jburch602/STM32F446RE_MPU6050_IMU/docs/images/v2_closed_loop_demo_thumbnail.jpg

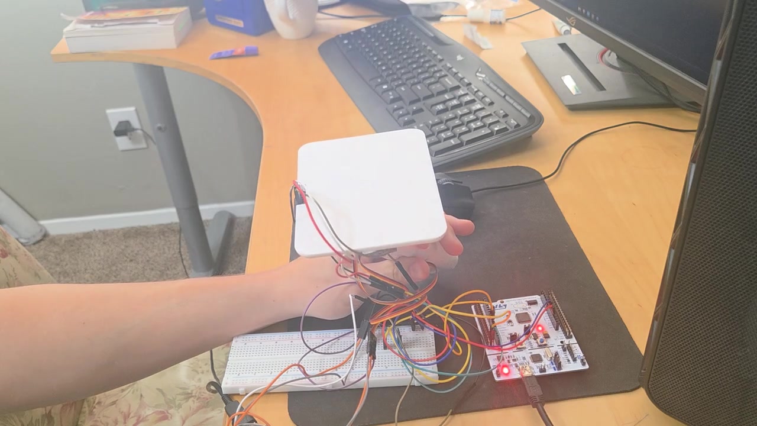
docs/images/v2_closed_loop_demo_thumbnail.jpg
