jburch602/STM32F446RE_MPU6050_IMU/docs/validation/spreadsheets/closed_loop_stabilization_2026-09-14.xlsx

Sheet: Overview
Closed-Loop Stabilization Validation
STM32F446RE + MPU6050 + two MG90S servos | September 14, 2026
Configuration | Value | Capture summary | Result
Control loop | 100 Hz | Samples | 800
Telemetry | 20 Hz | Analyzed window | 40.0 s
Controller | PI + direct gyro-rate damping | Max |relative pitch| | 15.87 deg
Kp (pitch / roll) | 1.25 / 1.25 | Max |relative roll| | 12.21 deg
Ki (pitch / roll) | 1.00 / 1.00 | Max |pitch command| | 60.00 deg
Krate (pitch / roll) | 0.05 / 0.05 | Max |roll command| | 56.54 deg
Attitude deadband | 0.5 deg | Mean dt | 0.0100 s
Servo command limit | +/-60 deg
Test notes
The workbook preserves the 90-130 s portion of the paired video/telemetry run, including baseline before motion and settling afterward. The source recording continued for several minutes after visible movement ended; that stationary tail is intentionally excluded. The source text contained one incomplete final CSV row, which was also excluded.
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
