jburch602/STM32F446RE_MPU6050_IMU/docs/validation/spreadsheets/servo_hysteresis_characterization_v1_v2.xlsx

Sheet: Raw_V1
V1 Raw Telemetry — Curated Near-Center Test
Copied verbatim from the prior curated V1 hysteresis workbook.
Time_ms | dt | AX_g | AY_g | AZ_g | GX_dps | GY_dps | GZ_dps | Pitch | Roll | Yaw | PitchError_deg | RollError_deg | PitchCommand_deg | RollCommand_deg | State | DataValid | SampleCount | ValidCount | FailedRead | FailedDt | FailedAngle | FailedTelemetry | ReadErrPct | TotalErrPct
13070 | 0.01 | 0.002 | -0.001 | 0.999 | 0.664 | -0.427 | 0.458 | -0.01 | -0.013 | 0.011 | 0 | 0 | 0 | 0 | 2 | 1 | 5 | 5 | 0 | 0 | 0 | 0 | 0 | 0
13120 | 0.01 | -0.005 | -0.001 | 0.985 | -0.198 | 0.321 | -0.183 | -0.009 | -0.018 | 0.008 | 0 | 0 | 0 | 0 | 2 | 1 | 10 | 10 | 0 | 0 | 0 | 0 | 0 | 0
13170 | 0.01 | 0.004 | 0.01 | 1.022 | -0.145 | -0.031 | 0.198 | 0.017 | 0.028 | 0.018 | 0 | 0 | 0 | 0 | 2 | 1 | 15 | 15 | 0 | 0 | 0 | 0 | 0 | 0
13220 | 0.01 | -0.015 | -0.011 | 0.993 | 0.679 | -0.282 | 0.42 | -0.001 | 0.004 | 0.012 | 0 | 0 | 0 | 0 | 2 | 1 | 20 | 20 | 0 | 0 | 0 | 0 | 0 | 0
13270 | 0.01 | -0.006 | 0.003 | 0.984 | -0.313 | -0.206 | -0.397 | -0.02 | 0.009 | 0.012 | 0 | 0 | 0 | 0 | 2 | 1 | 25 | 25 | 0 | 0 | 0 | 0 | 0 | 0
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
