jburch602/STM32F446RE_MPU6050_IMU/docs/validation/spreadsheets/deadband_baseline_db0.xlsx

Sheet: Raw Log
Time_ms | dt | AX_g | AY_g | AZ_g | GX_dps | GY_dps | GZ_dps | Pitch | Roll | Yaw | PitchError_deg | RollError_deg | PitchCommand_deg | RollCommand_deg | State | DataValid | SampleCount | ValidCount | FailedRead | FailedDt | FailedAngle | FailedTelemetry | ReadErrPct | TotalErrPct | Elapsed_s
13047 | 0.0000 | -0.006 | -0.008 | 0.999 | -0.137 | 0.153 | -0.061 | -0.007 | -0.009 | 0.000 | 0.007 | 0.009 | -0.007 | -0.009 | 2 | 1 | 1 | 1 | 0 | 0 | 0 | 0 | 0.000 | 0.000 | 0.000
13071 | 0.0240 | -0.003 | -0.001 | 1.006 | -0.160 | 0.130 | 0.023 | -0.007 | -0.007 | 0.001 | 0.007 | 0.007 | -0.007 | -0.007 | 2 | 1 | 2 | 2 | 0 | 0 | 0 | 0 | 0.000 | 0.000 | 0.024
13095 | 0.0240 | -0.011 | -0.003 | 1.004 | 0.115 | 0.137 | -0.183 | -0.017 | -0.013 | -0.004 | 0.017 | 0.013 | -0.017 | -0.013 | 2 | 1 | 3 | 3 | 0 | 0 | 0 | 0 | 0.000 | 0.000 | 0.048
13119 | 0.0240 | -0.005 | -0.003 | 1.019 | -0.031 | -0.260 | -0.382 | -0.028 | -0.014 | -0.013 | 0.028 | 0.014 | -0.028 | -0.014 | 2 | 1 | 4 | 4 | 0 | 0 | 0 | 0 | 0.000 | 0.000 | 0.072
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
