jburch602/STM32F446RE_MPU6050_IMU/docs/validation/spreadsheets/servo_hysteresis_near_center.xlsx

Sheet: Summary
Near-Center Servo Hysteresis / Dead-Zone Analysis
Test method

Sheet: Raw Telemetry
Time_ms | dt | AX_g | AY_g | AZ_g | GX_dps | GY_dps | GZ_dps | Pitch | Roll | Yaw | PitchError_deg | RollError_deg | PitchCommand_deg | RollCommand_deg | State | DataValid | SampleCount | ValidCount | FailedRead | FailedDt | FailedAngle | FailedTelemetry | ReadErrPct | TotalErrPct
13070.0000 | 0.0100 | 0.002 | -0.001 | 0.999 | 0.664 | -0.427 | 0.458 | -0.010 | -0.013 | 0.011 | 0.000 | 0.000 | 0.000 | 0.000 | 2.000 | 1.000 | 5.000 | 5.000 | 0.000 | 0.000 | 0.000 | 0.000 | 0.000 | 0.000
13120.0000 | 0.0100 | -0.005 | -0.001 | 0.985 | -0.198 | 0.321 | -0.183 | -0.009 | -0.018 | 0.008 | 0.000 | 0.000 | 0.000 | 0.000 | 2.000 | 1.000 | 10.000 | 10.000 | 0.000 | 0.000 | 0.000 | 0.000 | 0.000 | 0.000
13170.0000 | 0.0100 | 0.004 | 0.010 | 1.022 | -0.145 | -0.031 | 0.198 | 0.017 | 0.028 | 0.018 | 0.000 | 0.000 | 0.000 | 0.000 | 2.000 | 1.000 | 15.000 | 15.000 | 0.000 | 0.000 | 0.000 | 0.000 | 0.000 | 0.000
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
