jburch602/STM32F446RE_MPU6050_IMU/docs/validation/spreadsheets/slew_rate_aggressive_reversal_120dps.xlsx

Sheet: Raw Log
Time_ms | dt | AX_g | AY_g | AZ_g | GX_dps | GY_dps | GZ_dps | Pitch | Roll | Yaw | PitchError_deg | RollError_deg | PitchCommand_deg | RollCommand_deg | State | DataValid | SampleCount | ValidCount | FailedRead | FailedDt | FailedAngle | FailedTelemetry | ReadErrPct | TotalErrPct | Elapsed_s
13047 | 0.0000 | 0.010 | 0.002 | 1.006 | -0.092 | -0.122 | 0.313 | 0.011 | 0.002 | 0.000 | 0.000 | 0.000 | 0.000 | 0.000 | 2 | 1 | 1 | 1 | 0 | 0 | 0 | 0 | 0.000 | 0.000 | 0.000
13071 | 0.0240 | -0.011 | -0.004 | 0.998 | 0.031 | 0.145 | -0.168 | 0.002 | -0.003 | -0.004 | 0.000 | 0.000 | 0.000 | 0.000 | 2 | 1 | 2 | 2 | 0 | 0 | 0 | 0 | 0.000 | 0.000 | 0.024
13095 | 0.0240 | 0.005 | 0.004 | 1.003 | -0.053 | -0.099 | -0.015 | 0.005 | 0.003 | -0.004 | 0.000 | 0.000 | 0.000 | 0.000 | 2 | 1 | 3 | 3 | 0 | 0 | 0 | 0 | 0.000 | 0.000 | 0.048
13119 | 0.0240 | 0.012 | 0.004 | 0.997 | -0.160 | 0.153 | -0.053 | 0.022 | 0.011 | -0.006 | 0.000 | 0.000 | 0.000 | 0.000 | 2 | 1 | 4 | 4 | 0 | 0 | 0 | 0 | 0.000 | 0.000 | 0.072
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
