jburch602/STM32F446RE_MPU6050_IMU/docs/validation/images/near_center_hysteresis.png

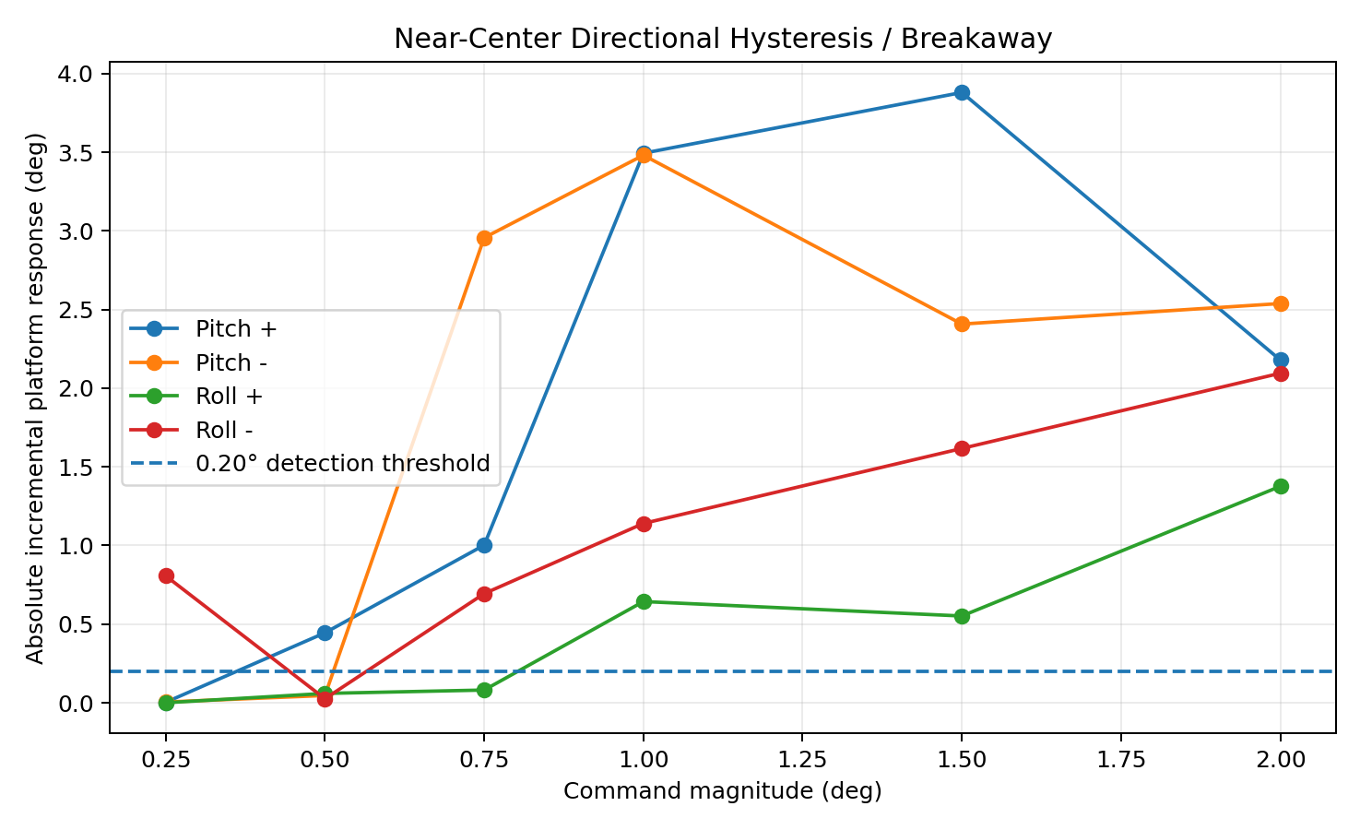
docs/validation/images/near_center_hysteresis.png
