jburch602/STM32F446RE_MPU6050_IMU/Core/Inc/power_monitor.h

/*
 * power_monitor.h
 *
 * Created on: Jul 8, 2026
 * Author: Jackson
 */

#ifndef INC_POWER_MONITOR_H_
#define INC_POWER_MONITOR_H_

#include "stm32f4xx_hal.h"


// Power system state
typedef enum {
    POWER_OK = 0,
    POWER_WARNING = 1,
    POWER_FAULT = 2
} Power_State_t;


// Power monitoring data
typedef struct {
    float voltage_raw;
    float voltage_filtered;
    float voltage_min;
    float voltage_max;

    Power_State_t state;

    uint32_t warning_count;
    uint32_t fault_count;
} Power_Monitor_t;


// Initializes power monitoring structure
HAL_StatusTypeDef Power_Manager_Init(
    Power_Monitor_t *monitor
);


// Reads voltage data from ADC
HAL_StatusTypeDef Power_Manager_Read(
    ADC_HandleTypeDef *hadc,
    Power_Monitor_t *monitor
);


// Updates power state based on voltage data
HAL_StatusTypeDef Power_Manager_Update(
    Power_Monitor_t *monitor
);


#endif /* INC_POWER_MONITOR_H_ */
