jburch602/STM32F446RE_MPU6050_IMU/(commit log)

2026-07-01 Initial STM32F446RE MPU6050 IMU project
2026-07-02 Add WHO_AM_I check and sensor data struct
2026-07-02 Add function to read accelerometer data
    Has NULL pointer validation
2026-07-02 Added function for gyro raw read
    Also added test code in main.c
2026-07-02 Added UART2 serial output
2026-07-03 Added time to print, logged csv
    From about 40min data
    gyro avg bias
    gyro_x = -1.89 DPS
    gyro_y = -1.20 DPS
    gyro_z = -3.65 DPS
    accelerometer avg bias
    accel_x = 0.019 g
    accel_y = 0.012 g
    accel_z = 1.102 g
2026-07-04 Add sample calibration
    Mean values after calibration
    accel_x_g: -0.00068 g
    accel_y_g: -0.00107 g
    accel_z_g: 0.99885 g
    gyro_x_dps: 0.03786 dps
    gyro_y_dps: 0.00861 dps
    gyro_z_dps: -0.03247 dps
    this represents about 98.8% improvement from pre-calibrated data
    gyro drift is about 1.95deg/min instead of 219deg/min
    [main.c, mpu6050.c, mpu6050.h]
2026-07-04 Add angles and complementary filter
    Implement pitch, roll, and yaw angle estimation using a complementary filter that combines accelerometer and gyroscope data.
    Adds MPU6050_Angles_t struct to store angle state and timing information.
    Introduces three new functions: MPU6050_Update_dt() for delta time calculation, MPU6050_Calculate_Angles() for angle computation, and MPU6050_Update_All() to orchestrate all operations.
    Updates main.c to output angles in CSV format alongside IMU sensor data.
    Needs explanatory comments
    Pitch and roll are about stationary
    Noise significantly reduced by complementary filter ~90%
    Yaw drifts 0.63 deg/min
    Yaw is hardware limited by the MPU6050 lack of a magnetomet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
    [main.c, mpu6050.c, mpu6050.h]
2026-07-04 Refactor timing and angle calculations
    add imu_filter.c for modularity
2026-07-04 Add system health monitoring module
    Introduce system health monitoring infrastructure with System_State_t enum tracking boot, calibration, running, and error states. Define System_Health_t structure to track sample counts, error metrics, HAL status codes, and health statistics.
    [system_health.c, system_health.h, telemetry.h]
2026-07-05 Implement system health monitor
    Add system health tracking module to monitor MPU6050 sensor performance and errors. Includes:
    - New System_Health_t struct with detailed error counters and statistics
    - Refined system state enum with separate DT and angle error states
    - Functions for recording samples, errors, and calculating error rates
    - Integration into main loop to track sensor reliability
    - Fixed include guard typo in telemetry.h and improved code formatting
    [main.c, system_health.c, system_health.h, telemetry.h]
2026-07-05 Integrate system health into telemetry
    Add system health monitoring to telemetry output and initialization flow. Includes health metrics in CSV data logging, sends status messages during MPU initialization and calibration, and adds new Telemetry_Send_Status() function for reporting system state changes over UART.
2026-07-05 Add I2C bus recovery on startup
    Implement an I2C bus recovery routine to handle stuck I2C1 bus issues that occur during rapid firmware restarts. The recovery logic manually pulses SCL up to 9 times to release a stuck SDA line, then generates a STOP condition. This routine is called before normal I2C1 initialization to prevent HAL_BUSY errors during MPU6050 initialization. Also added boot status telemetry message.
    [i2c_manager.c, i2c_manager.h, main.c]
2026-09-05 Add Power Monitor
    WIP code, likely to refactor
2026-09-05 Add Servo 1 test
    CubeMX generated
2026-09-07 Add servo control and IMU updates
    This change adds PWM servo support for pitch and roll channels, configures TIM4/TIM8 outputs, and initializes the servos during boot. It also updates the IMU complementary filter to use calibrated physical pitch/roll axes, integrates yaw, and improves timing handling. The main loop now initializes the MPU6050, calibrates it, streams telemetry, and monitors health while driving the servos. Power-monitor APIs were cleaned up and aligned with the HAL signatures.
2026-09-07 Add gimbal module and replace direct servo control
    Introduce a gimbal module (Core/Inc/gimbal.h and Core/Src/gimbal.c) that encapsulates pitch/roll Servo_t instances, calibration constants (min/center/max pulses), servo direction signs, KP gains, and a clamp for safe motion. Implements Gimbal_Init, Gimbal_Center and Gimbal_Update to initialize, center, and drive servos from filtered IMU angles. Update Core/Src/main.c to use Gimbal_t with Gimbal_Init/Gimbal_Update, removing the previous per-servo initialization and hardcoded center defines. Preserves existing error handling and integrates the gimbal abstraction cleanly.
    [gimbal.c, gimbal.h, main.c]
2026-09-07 Gimbal: add deadband, init flow & servo API
    Add deadband support and refactor gimbal + servo init/update behavior. gimbal.h: new deadband defines. gimbal.c: new Gimbal_ApplyDeadband(), apply deadband to pitch/roll errors, rename offset vars, clamp in degrees, and start each servo at calibrated center instead of a generic center. main.c: moved Gimbal_Init earlier, added error check and brief delay. mpu6050.c: reduce required valid calibration samples from 2000 to 1000 (faster calibration). servo.c: Servo_Init no longer starts PWM; added Servo_Start(pulse_us) which clamps pulse to min/max and starts PWM. These changes reduce jitter at level and avoid unnecessary servo movement on startup.
    [gimbal.c, gimbal.h, main.c, mpu6050.c, servo.c]
2026-09-07 Add Servo_Start to header
    fix missing header function
    [servo.h]
2026-09-07 Add gimbal telemetry and refactor update
    Store gimbal error/command state and export it via telemetry. Changes: set pitch/roll deadbands to 0.0; add pitch_error_deg, roll_error_deg, pitch_command_deg, roll_command_deg to Gimbal_t; refactor Gimbal_Update to populate and use these fields (apply deadband, compute P command, clamp, and set servos). Telemetry: include gimbal header fields (PitchError_deg, RollError_deg, PitchCommand_deg, RollCommand_deg), increase UART buffer, and update Telemetry_Send_CSV signature and caller in main. Misc: include gimbal.h where needed and clean up formatting for robustness. This enables logging and debugging of the gimbal controller.
    [gimbal.c, gimbal.h, main.c, telemetry.c, telemetry.h]
2026-09-07 Add gimbal param to telemetry CSV prototype
    fix
    [gimbal.c, telemetry.h]
2026-09-07 Add slew limit
    This update adds a small deadband around level and a per-axis slew-rate limit to the gimbal controller so it responds smoothly without abrupt movement. The controller now tracks target commands separately from the actual command values and resets the control state during init. It also increases the telemetry UART buffer so CSV output is not truncated.
    [gimbal.c, gimbal.h, telemetry.c]
2026-09-07 Add integral state to gimbal control
    This updates the gimbal controller to support integral action alongside proportional control. It adds Ki configuration, integral accumulation and reset logic, per-axis P/I term tracking, and refactors the update path to apply deadband, clamping, and slew-rate limiting in a clearer sequence. The controller state is reset on init and center so startup behavior remains consistent.
    [gimbal.c, gimbal.h]
2026-09-07 Add anti-windup and refactor gimbal integrator
    Introduce a compile-time toggle GIMBAL_ANTI_WINDUP_ENABLED in Core/Inc/gimbal.h (default 0). Extend Gimbal_UpdateIntegral to accept current control and output limit and implement conditional integration (anti-windup) when enabled: only integrate when output not saturated or when error drives output back toward range. Refactor Gimbal_Update in Core/Src/gimbal.c to compute P/I terms and controller outputs before updating integrals and add local pitch_control_deg / roll_control_deg variables. Behavior unchanged when anti-windup is disabled.
    [gimbal.c, gimbal.h]
2026-09-07 Add USART2 DMA TX support and TIM6
    Add DMA support for USART2 TX (DMA1_Stream6) by adding Core/Inc/dma.h and Core/Src/dma.c, wiring hdma_usart2_tx in usart.c, and registering DMA IRQ handler. Introduce TIM6 (MX_TIM6_Init, NVIC setup and IRQ) and call MX_TIM6_Init from main. Update main to initialize DMA and TIM6, increase USART2 baud to 460800, and adjust system/telemetry/state call formatting. Update interrupt handlers (stm32f4xx_it), HAL MSP NVIC priority grouping, and project files (.ioc, .mxproject) to include new files and DMA/TIM6 configuration.
2026-09-07 Add DMA telemetry over UART
    This change moves CSV telemetry transmission to non-blocking UART DMA, tracking active transfers and clearing the state from UART completion/error callbacks. The main loop now starts DMA sends and tolerates HAL_BUSY while a previous transfer is active, improving throughput without blocking the control loop.
    [main.c, telemetry.c, telemetry.h]
2026-09-07 Add 100 Hz TIM6 control scheduler
    - Replace HAL_Delay loop pacing with TIM6 interrupts
    - Run control loop at deterministic 10 ms intervals
    - Decouple telemetry to 20 Hz over UART DMA
    - Reduce control period from ~13 ms to 10 ms
    - Maintain zero observed system errors during motion testing
    [main.c]
2026-09-07 Add derivative control to gimbal
    This change adds a derivative term to the gimbal PID loop by introducing KD gains and derivative state tracking for pitch and roll. It computes error-rate feedback from successive samples, initializes and resets derivative state during startup and centering, and includes the D-term in the control output while keeping the existing deadband, integral, slew-rate, and anti-windup behavior intact.
    [gimbal.c, gimbal.h]
2026-09-08 Document V1 gimbal validation and tuning status
    Expanded the project README into a V1 gimbal controller overview, including architecture, timing, hardware, mechanical findings, and validation status. Added a validation hub with measured deadband, slew-rate, and near-center hysteresis data plus supporting plots and spreadsheets to preserve the engineering evidence behind the control decisions.
    [deadband_baseline_db0.xlsx, deadband_validation_db0p5.xlsx, servo_hysteresis_near_center.xlsx, slew_rate_aggressive_reversal_120dps.xlsx]
2026-09-09 Add V2 hysteresis analysis and artifacts
    Update README to describe V2 mechanical assembly and open-loop actuator characterization, clarify control decision to tune P-only with Ki=0 and Kd=0, and document empirical findings (direction- and history-dependent hysteresis, branch gaps, platform gain, cross-axis coupling). Add docs/validation/hysteresis.md with detailed servo hysteresis analysis and include the consolidated raw-data workbook docs/validation/spreadsheets/servo_hysteresis_characterization_v1_v2.xlsx. Refresh docs/validation/README.md to reference the new analysis and artifacts.
    [servo_hysteresis_characterization_v1_v2.xlsx]
2026-09-09 Add V2 prototype image and redesign notes
    This commit adds the V2 gimbal prototype photo to the project README and explains the redesigned upper-stage assembly. It highlights the improved centering and stiffness, the residual static lean, and how the remaining error is better attributed to servo hysteresis and mechanical asymmetry rather than gross structural compliance.
2026-09-14 Add gyro-rate damping to gimbal controller
    This change upgrades the gimbal controller to use direct MPU6050 gyro-rate feedback for damping, along with updated servo calibration, sign conventions, PI gains, deadbands, anti-windup handling, and slew-rate limiting. The public Gimbal_Update API now accepts MPU data, controller state is reset consistently on init and center, and derivative telemetry remains available while KD stays at zero for the current control law.
    [gimbal.c, gimbal.h]
2026-09-14 Refactor MPU6050 driver: calibration & API overhaul
    Rework MPU6050 driver for clarity, robustness and correct calibration.
    Changes:
    - Restructured public types (MPU6050_Data_t, MPU6050_Bias_t) and APIs.
    - Added MPU6050_Init, MPU6050_Read_All, MPU6050_Calibrate_Gyro, MPU6050_Read_Accel_Raw, MPU6050_Read_Gyro_Raw and conversion helpers.
    - Introduced permanent per-axis accelerometer offset/scale constants and removed reliance on startup orientation for accel calibration.
    - Gyroscope zero-rate bias is measured at startup (configurable sample counts/delays).
    - Configure and verify sensor FS: accel +/-2g (16384 counts/g), gyro +/-1000 dps (32.8 counts/dps).
    - Improved register read/write helpers,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
    [mpu6050.c, mpu6050.h]
2026-09-14 Tune gimbal control and IMU estimator (STABLE)
    This patch refines the MPU6050 attitude estimator and the two-axis gimbal controller. It adds adaptive complementary-filter trust logic, captures a startup attitude reference for zero-setpoint control, updates controller gains and direct gyro damping, and improves integral unwind/anti-windup behavior. Servo center and mechanical limits were adjusted, and telemetry was simplified for easier tuning and debugging.
2026-09-15 Refresh project docs for v2 closed-loop demo
    Updated the project README to describe the current two-axis closed-loop stabilization system, demo video, configuration, timing, and validation summary. Added the September 14, 2026 demo thumbnail and workbook artifact, and expanded the validation docs with the new closed-loop telemetry evidence, hysteresis context, and engineering interpretation for the V2 prototype.
    [closed_loop_stabilization_2026-09-14.xlsx]
2026-09-15 Update demo section in README.md
    Removed demo image link and added video link for V2 prototype.
